serrauvic/ros_delta_robot/README.md

## ROS delta robot.

* delta_robot_support
Project containing global launch files,URDFs and meshes.

* delta_robot_kinematics
Package kinematics library

* delta_robot_img_processor
ROS image processor for detecting circles.

* delta_robot_firmware
Arduino src code

* delta_robot_drivers
Delta robot driver and kinematic solver.

* How to launch

* Load firmware to arduiono UNO

catkin_make delta_robot_firmware_src_delta_arduino-upload

roslaunch delta_robot_support delta_robot_sim.launch

roslaunch delta_robot_support delta_robot_real.launch

**Looking for more information?** Visit the delta_documentation folder. There can be found simulations in scilab and all the equation development for the kinematic problems. There are also all the mechanical parts printed for the project in the delta_mechanical folder. 

Assembly test one (https://www.youtube.com/watch?v=qOeS8mAfZcc)
Assembly test two (https://www.youtube.com/watch?v=pI4uqf1SEYo)
