serrauvic/ros_delta_robot/delta_documentation/PROJECTE D’INTEGRACIÓ - ROBOT DELTA - PRESENTACIÓ.pdf

# PROJECTE D’INTEGRACIÓ

Disseny i construcció d’un robot Delta

# Cinemàtica

- Requisits de disseny
- Equacions cinemàtiques
- Parell motor
- Dimensionament de la plataforma
- Trajectòries
- Document final

# Cinemàtica - Requisits de disseny

Donat l’enunciat, cal decidir la zona de treball del robot delta. Com l’alçada ve fixada pel suport, es decideix una zona de treball de:

- Rang de les X: +-0.175m
- Rang de les Y: +-0.175m
- Rang de les Z: -0.25m

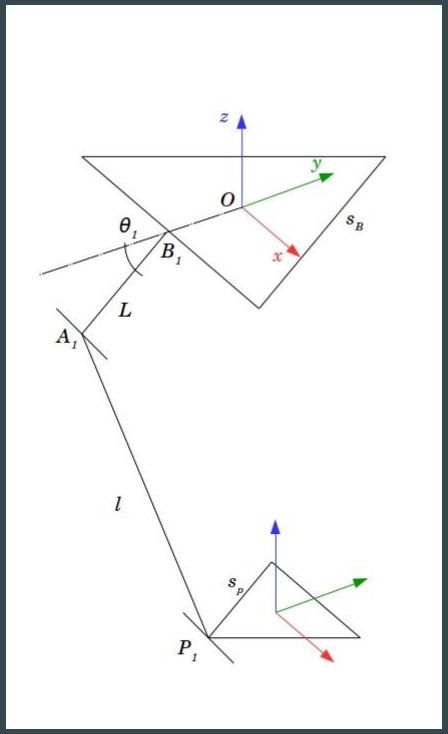
[picture p1: figure]

# Cinemàtica - Equacions cinemàtiques*

Es parteix del següent model simplificat i es busquen les equacions de manera que tot quedi en funció dels angles dels motors i la posició de l’end-effector.

Els punts sobre els que es calculen les equacions són les joints:

Bi

, Ai

i Pi

*Les equacions cinemàtiques es treuen de l’article: The Delta Parallel Robot: Kinematics Sollutions. R.L. Williams

# Cinemàtica - Equacions cinemàtiques

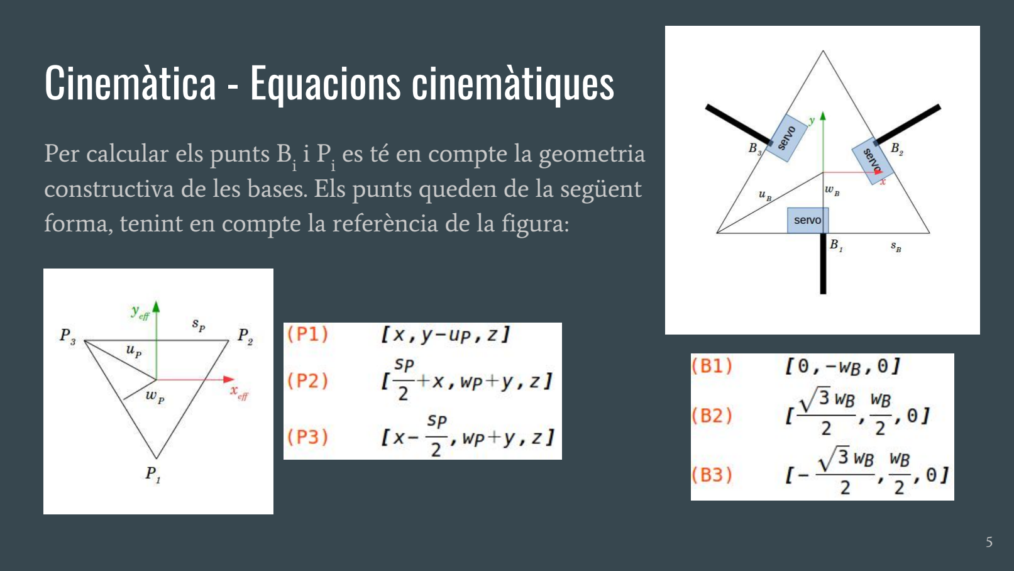
[picture p2: page 5]

Per calcular els punts Bi

i Pi

es té en compte la geometria constructiva de les bases. Els punts queden de la següent forma, tenint en compte la referència de la figura:

# Cinemàtica - Equacions cinemàtiques

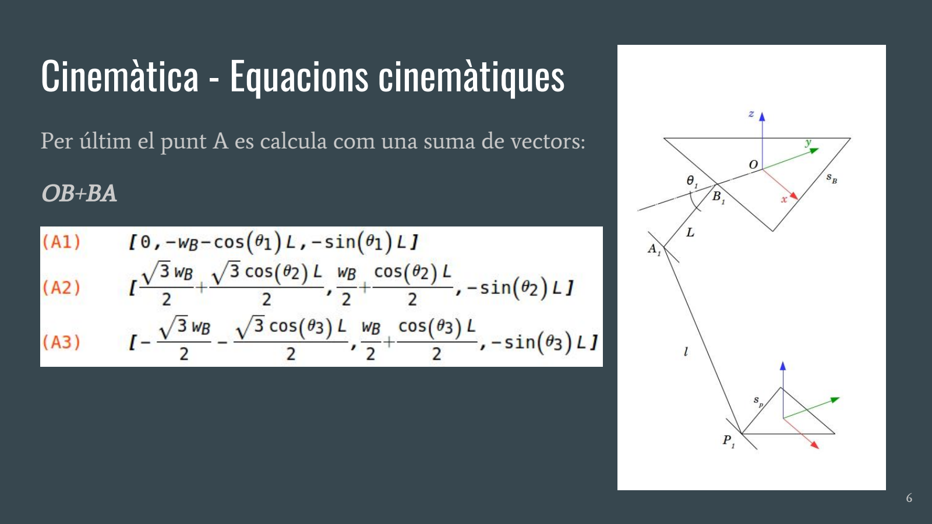
[picture p3: page 6]

Per últim el punt A es calcula com una suma de vectors:

OB+BA

# Cinemàtica - Equacions cinemàtiques

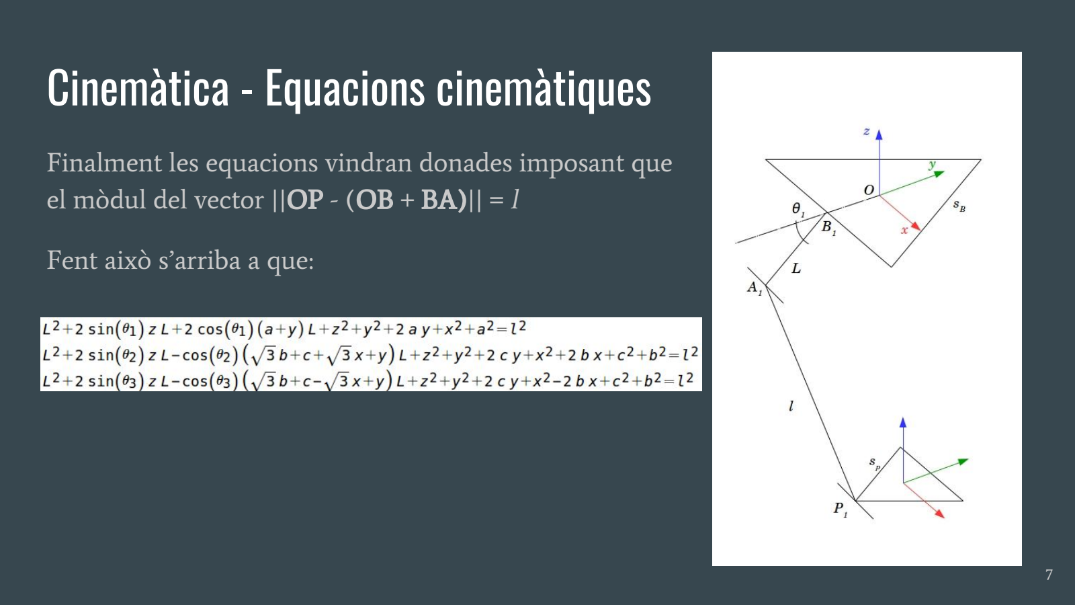
[picture p4: page 7]

Finalment les equacions vindran donades imposant que el mòdul del vector ||OP - (OB + BA)|| = l

Fent això s’arriba a que:

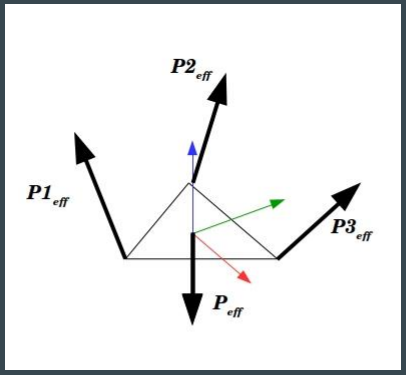
[picture p5: figure]

# Cinemàtica - Parell motor

L’objetiu és trobar l’expresió del parell que ha de fer cada motor en cada configuració. Per fer-ho es parteix de la base on hi va l’end-effector.

Llavors es crea un sistema d’equacions per l’eix {X,Y,Z} de manera que la suma de les components de cada vector Pi

sigui zero. Per fer-ho és necessari resoldre primer les equacions del sistema per saber com està posicionat l en l’espai.

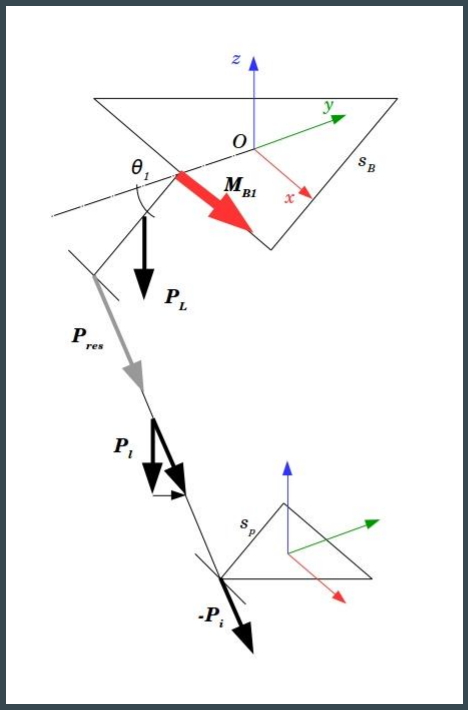
[picture p6: figure]

# Cinemàtica - Parell motor

Coneguts els vectors Pi

, es projecta el pes de la barra per sumar-lo a aquest vector i tot es trasllada a la joint del braç L (P
res

). A partir d’aquí s’aplica la fórmula del moment respecte d’un punt, essent l’interessant aquell alineat amb l’eix del motor.

# Cinemàtica - Dimensionament de la plataforma

Es segueixen els passos següents:

1) Sondeig global:
a) Es proposa un rang de treball en cada eix
b) Es proposen uns rangs de mides de la base, links i l’end effector
c) Es defineix el pes per unitat de distància de cada part (depèn del material)
d) Es defineix el parell màxim que pot fer cada actuador
e) Es defineix un mínim de l’espai cobert per la solució
2) Es fa córrer la simulació
3) Es destrien els candidats segons: Parell màxim/Volum cobert/Jacobiana*

*Segons: “Kinetostatic Performance Analysis of a Reconfigurable Delta-type Parallel Robot”. R.E. Sánchez, J.J. González, E. Castillo, A.L. Balmaceda

# Cinemàtica - Dimensionament de la plataforma

Es segueixen els passos següents:

4) Es fa un anàlisi exhaustiu de la solució triada, com per exemple la seva zona de treball:

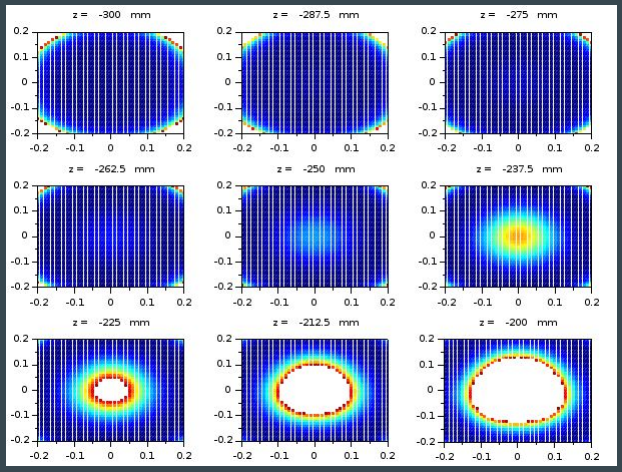
[picture p7: figure]

# Cinemàtica - Dimensionament de la plataforma

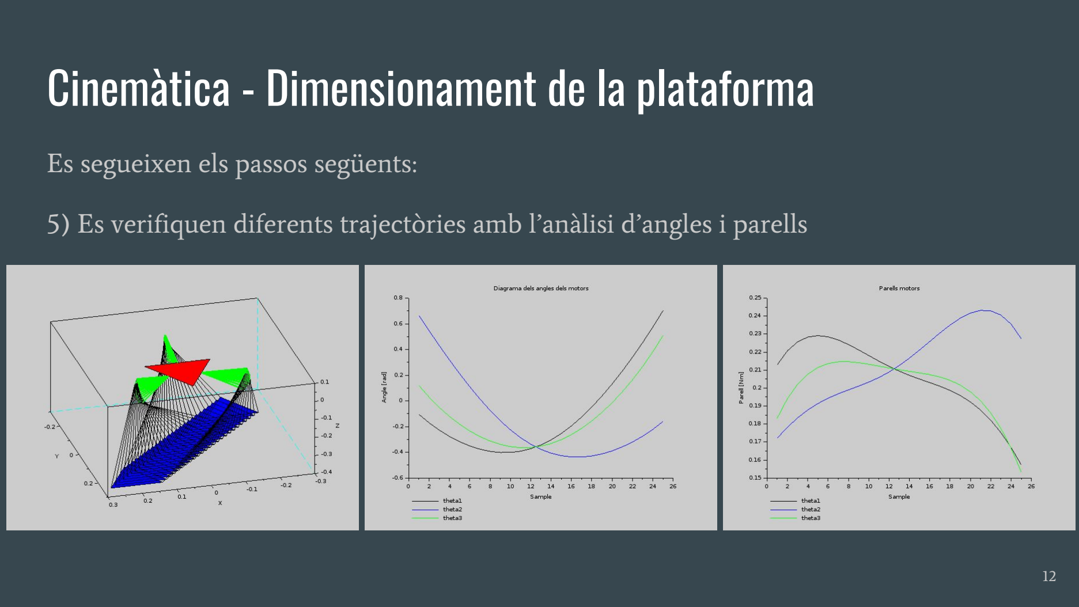
[picture p8: page 12]

Es segueixen els passos següents:

5) Es verifiquen diferents trajectòries amb l’anàlisi d’angles i parells

# Cinemàtica - Trajectòries

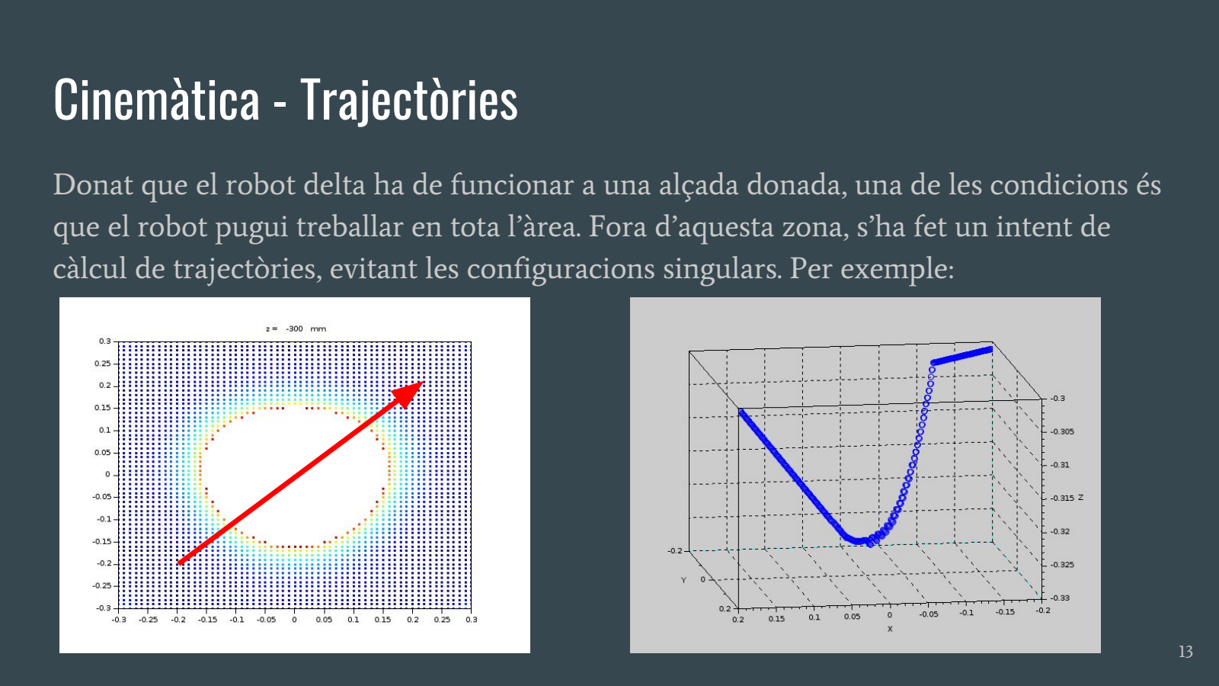
[picture p9: page 13]

Donat que el robot delta ha de funcionar a una alçada donada, una de les condicions és que el robot pugui treballar en tota l’àrea. Fora d’aquesta zona, s’ha fet un intent de càlcul de trajectòries, evitant les configuracions singulars. Per exemple:

# Cinemàtica - Trajectòries

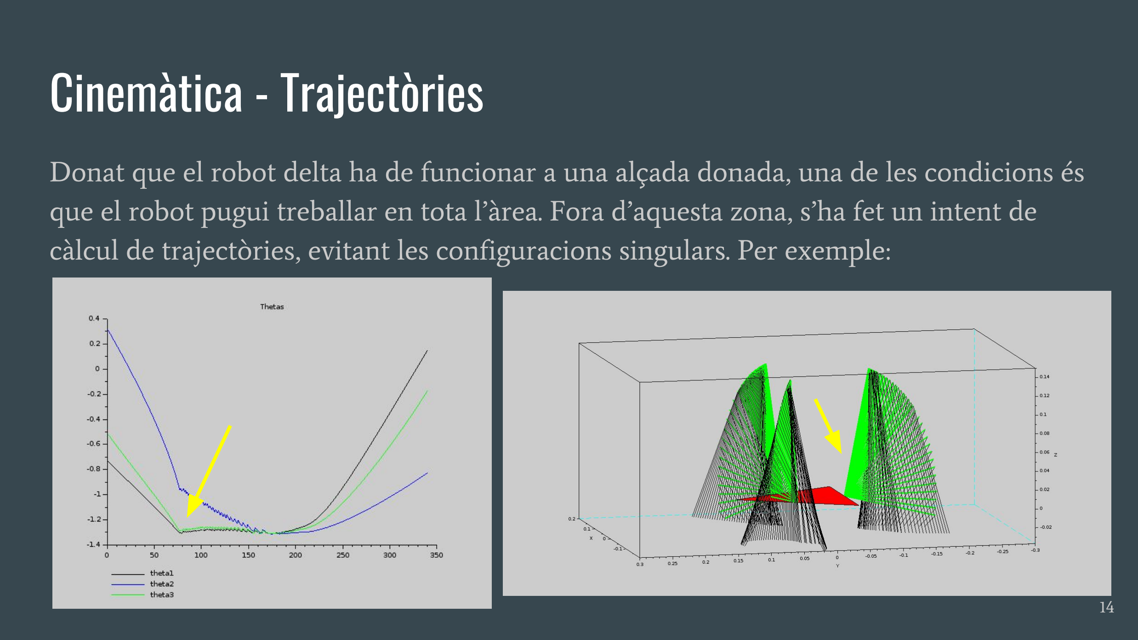
[picture p10: page 14]

Donat que el robot delta ha de funcionar a una alçada donada, una de les condicions és que el robot pugui treballar en tota l’àrea. Fora d’aquesta zona, s’ha fet un intent de càlcul de trajectòries, evitant les configuracions singulars. Per exemple:

# Cinemàtica - Document final

Quan tot està validat es genera un document per fer la part mecànica

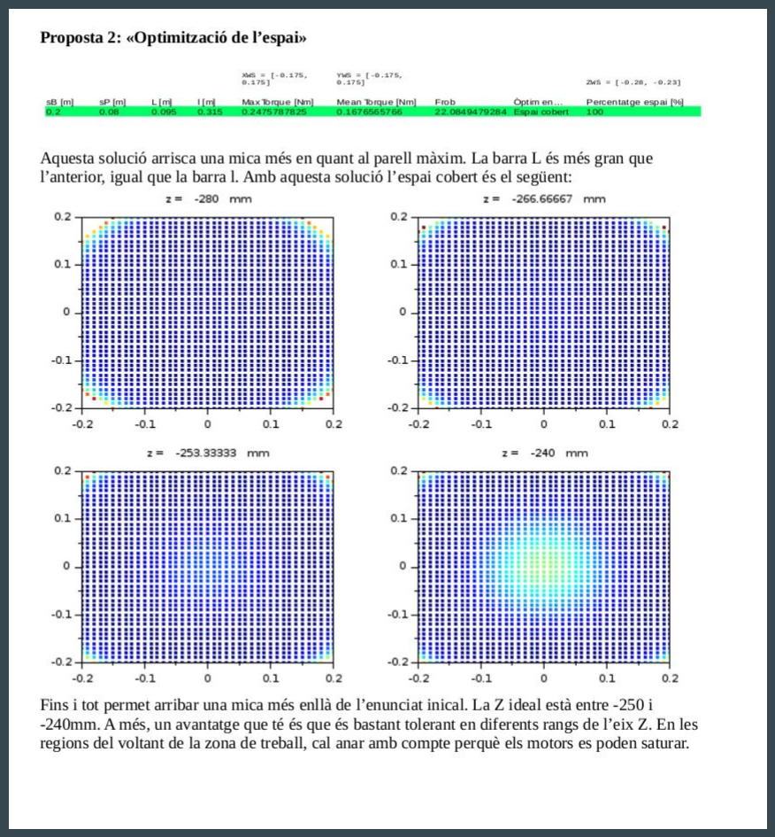
[picture p11: figure]

Proposta 1: “Optimització de material (parell)”

Proposta 2: “Optimització de l’espai”

Proposta 3: “L’aposta segura”

# Software - Subscriure posició

Implementar la funció del scilab a C++

Pàrametres funció inversekinemàtics (x,y, z(cte), array angles)

Forçar uns valors de posició (x,y) per comprobar que els angles obtinguts coincideixen amb els càlculs previs (Scilab)

# Software - Publicar Àngles

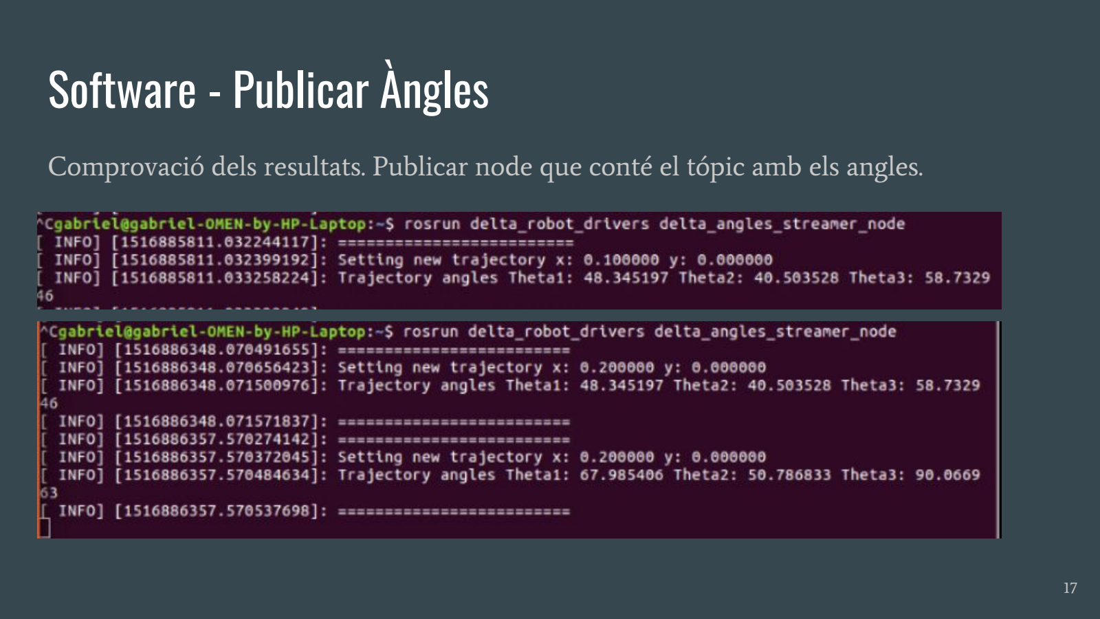
[picture p12: page 17]

Comprovació dels resultats. Publicar node que conté el tópic amb els angles.

# Software - Trajectoria

A partir del vector unitari es controlarà la trajectoria.

S’aplicarà un increment (definit al codi) amb el qual controlarem el moviment del robot.

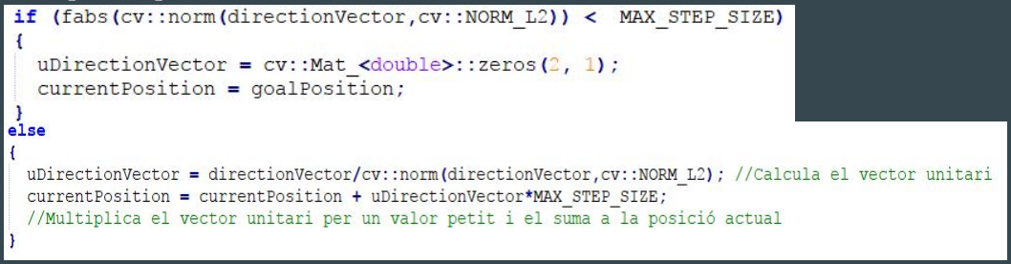
[picture p13: figure]

Exemple: Step size 0.1

# Software - Trajectoria

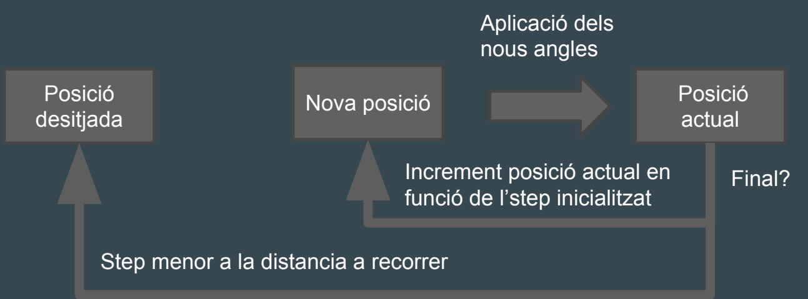
[picture p14: figure]
Nova posició; Posició; actual; Posició desitjada; Aplicació dels nous angles; Final? Increment posició actual en funció de l’step inicialitzat; Step menor a la distancia a recorrer

# Software - Arquitectura

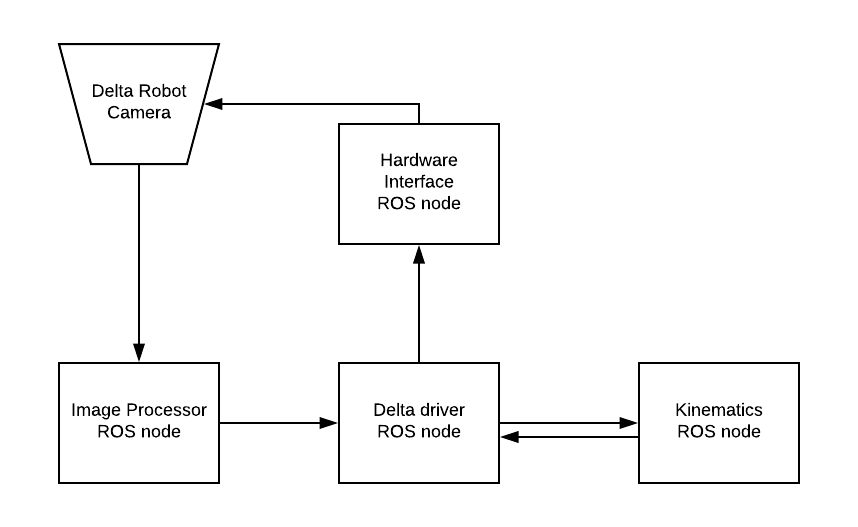
[picture p15: figure]

# Mecànica

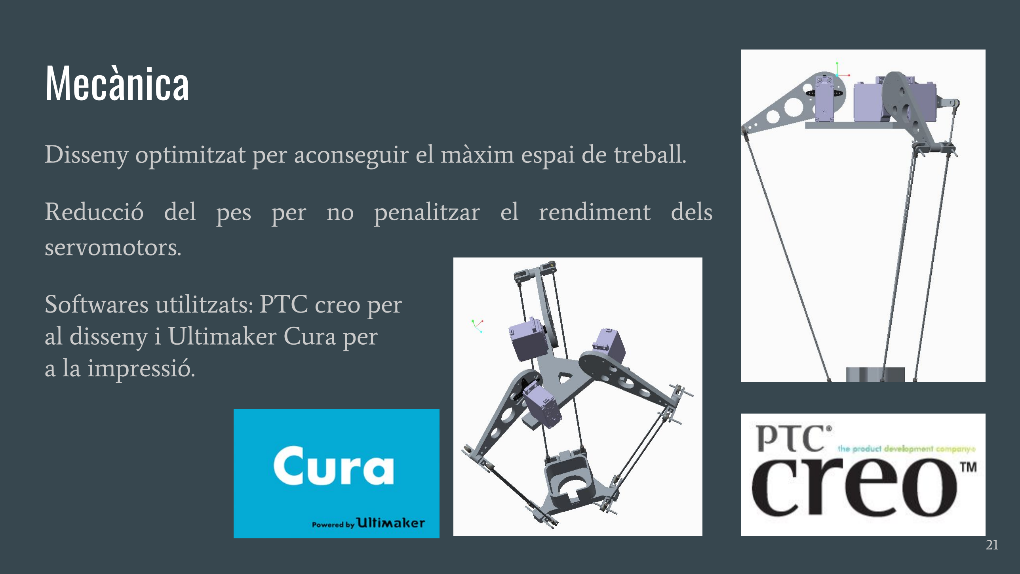
[picture p16: page 21]

Disseny optimitzat per aconseguir el màxim espai de treball.

Reducció del pes per no penalitzar el rendiment dels servomotors.

Softwares utilitzats: PTC creo per
al disseny i Ultimaker Cura per
a la impressió.

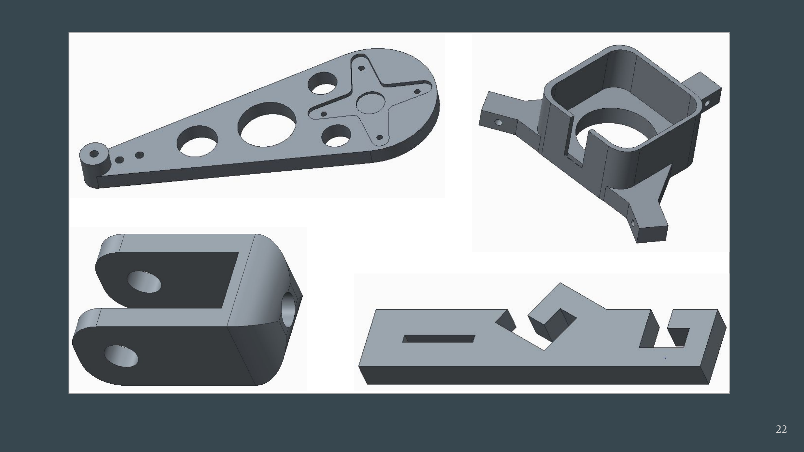
[picture p17: page 22]

# Rapid manufacturing

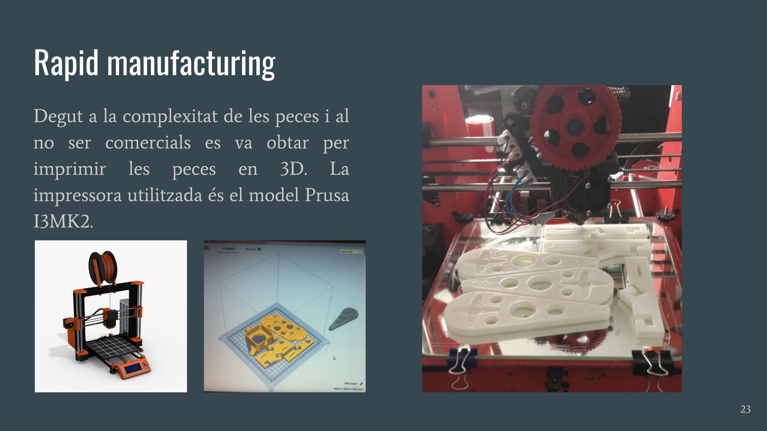
[picture p18: page 23]

Degut a la complexitat de les peces i al no ser comercials es va obtar per imprimir les peces en 3D. La impressora utilitzada és el model Prusa I3MK2.

# Millores PROTO 1

Optimització grau de llibertat ofert per les ròtules:

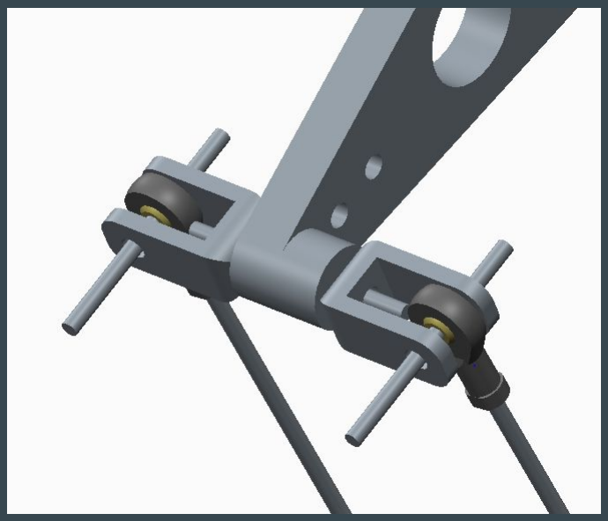
[picture p19: figure]
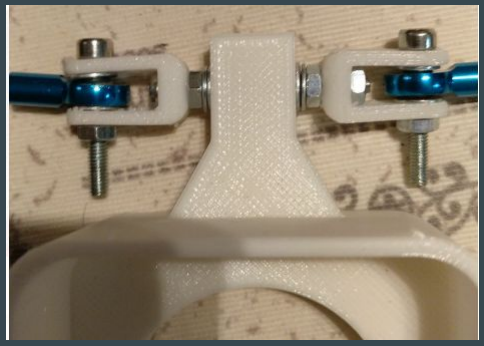
[picture p20: figure]

# Moltes gràcies per la vostra atenció!

Autors:
David Vives Colom
Gabriel Felez Palacios
Sebastian Serra Landete
Sergi Fabregó Serrat
Xavier Ortiz-Quintana Escardivol Josep Maria Fernández Mola

https://github.com/serrauvic/ros_delta_robot
