serrauvic/ros_delta_robot/delta_documentation/wxMax_eqs/Eqs_estat_htmlimg/Eqs_estat_0.png

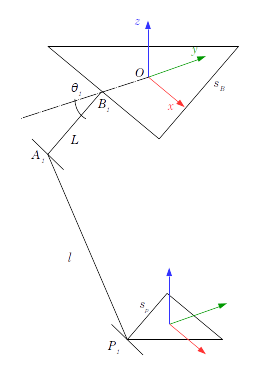
delta_documentation/wxMax_eqs/Eqs_estat_htmlimg/Eqs_estat_0.png
