serrauvic/ros_delta_robot/delta_mechanical/biceps.stp

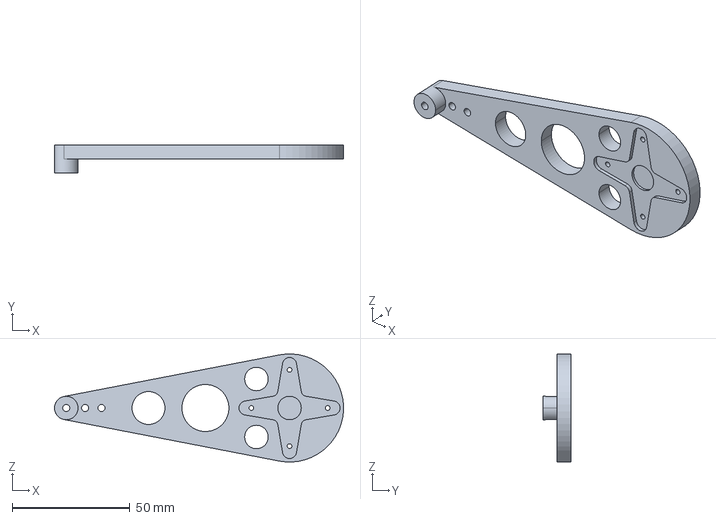
[picture p23: CAD file, 2018-02-15]
delta_mechanical/biceps.stp
123.0 x 12.0 x 45.9 mm
