serrauvic/ros_delta_robot/delta_robot_support/urdf/meshes/upper_leg.STL

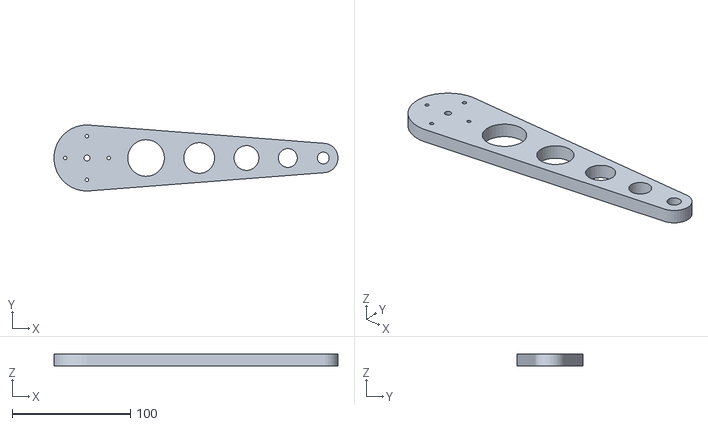
[picture p24: CAD file, 2018-01-26]
delta_robot_support/urdf/meshes/upper_leg.STL
240.4 x 56.0 x 10.0
