serrauvic/ros_delta_robot/delta_mechanical/base.stp

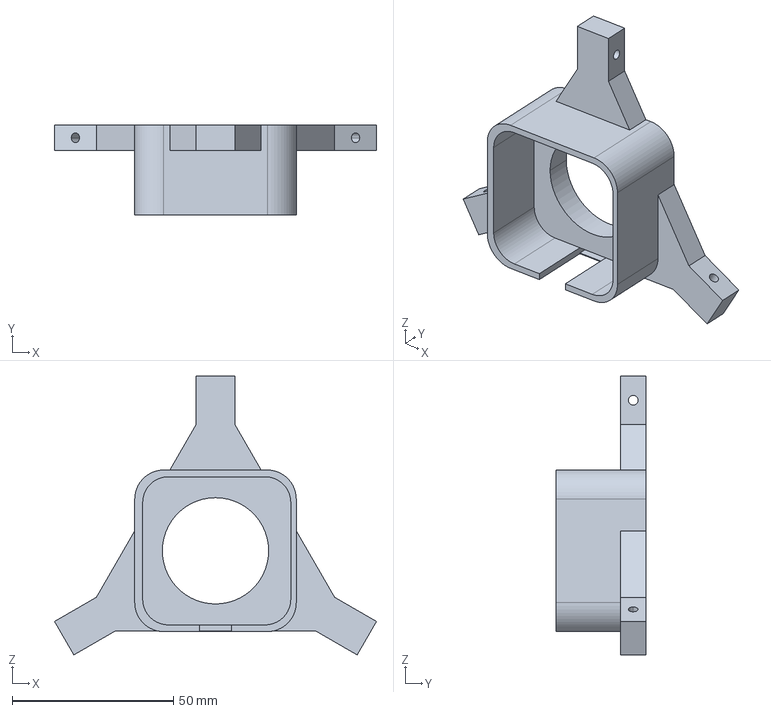
[picture p25: CAD file, 2018-02-15]
delta_mechanical/base.stp
100.0 x 28.0 x 86.6 mm
