serrauvic/ros_delta_robot/delta_robot_support/urdf/meshes/Platform.STL

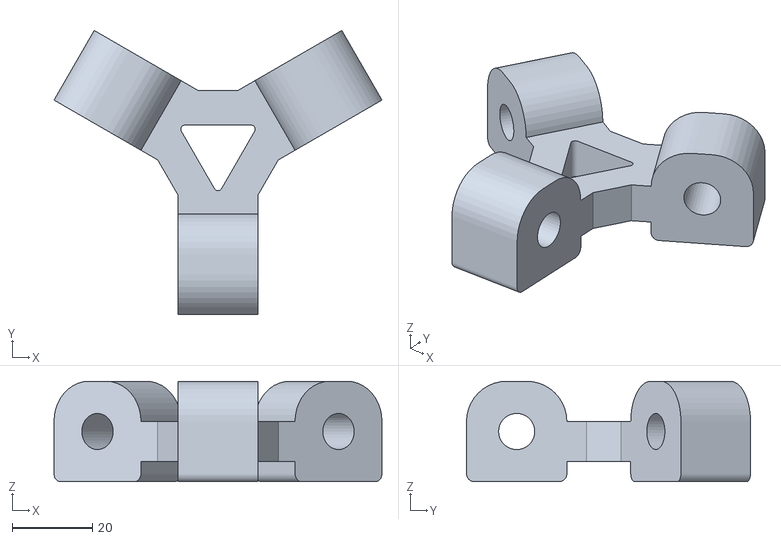
[picture p26: CAD file, 2018-01-26]
delta_robot_support/urdf/meshes/Platform.STL
81.7 x 70.7 x 25.0
