serrauvic/ros_delta_robot/delta_mechanical/mountingbracket.stp

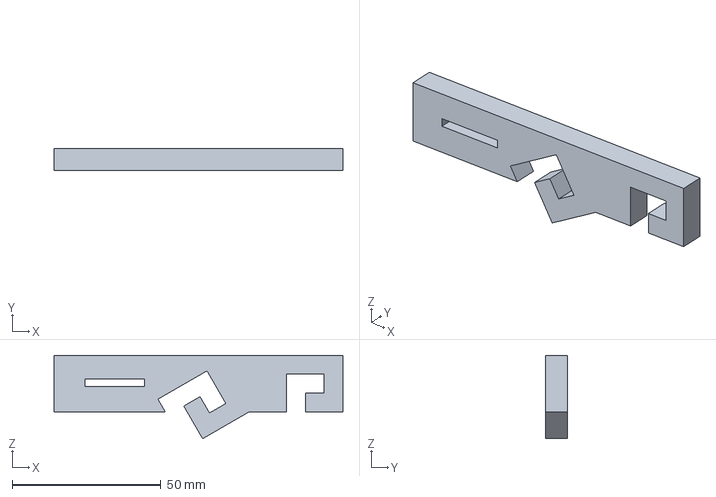
[picture p27: CAD file, 2018-02-15]
delta_mechanical/mountingbracket.stp
97.0 x 7.50 x 28.0 mm
