serrauvic/ros_delta_robot/delta_mechanical/unio.stp

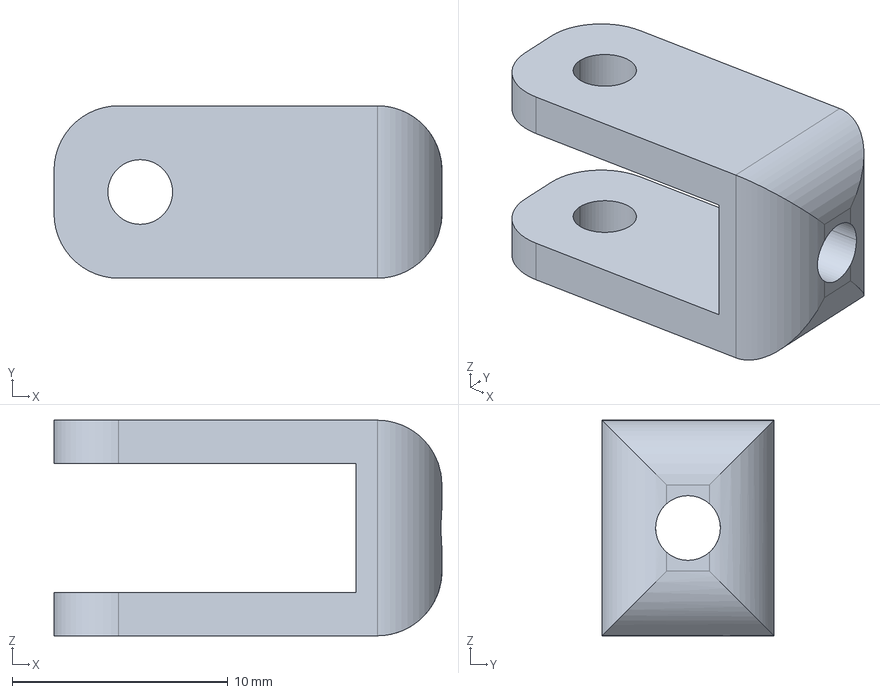
[picture p28: CAD file, 2018-02-15]
delta_mechanical/unio.stp
18.0 x 8.00 x 10.0 mm
