serrauvic/ros_delta_robot/(commit log)

2018-01-25 error detection & offset applied
    [delta_angles_streamer.cpp, delta_angles_streamer_node.cpp]
2018-01-26 added arduino firmware and roscontrol
    [Platform.STL, controllers.yaml, delta_robot.urdf, upper_leg.STL]
2018-02-08 Relative reference and some bugs fixed. Added a proportional controller
    [delta_angles_streamer.cpp, delta_angles_streamer_node.cpp]
2018-02-15 Added Scilab and wxMaxima worksheets
    Added some files with kinematics for further explanations. The wxMaxima folder contains the equation development for getting the state equations. The Scilab folder contains some simulations for the Delta robot.
2018-02-15 Step files added
    Added the mechanical folder with all its components
    [base.stp, biceps.stp, mountingbracket.stp, unio.stp]
2018-02-15 Readme explaining mechas
    Added a couple of lines explaining that there is some mechanical information in the mechanical folder
